Animesh810/Potentiostat/README.md

# Potentiostat
Potentiostat with an accuracy of 1mA over -0.7V to 0.7V.

The device is used to perform cyclic voltamettry. 
For more details read the report included.

Originally tested in Arduino Mega and Arduino Nano.
But can be used on any Arduino.
