Animesh810/Potentiostat/pics of report/R = 1Kohm (1).png

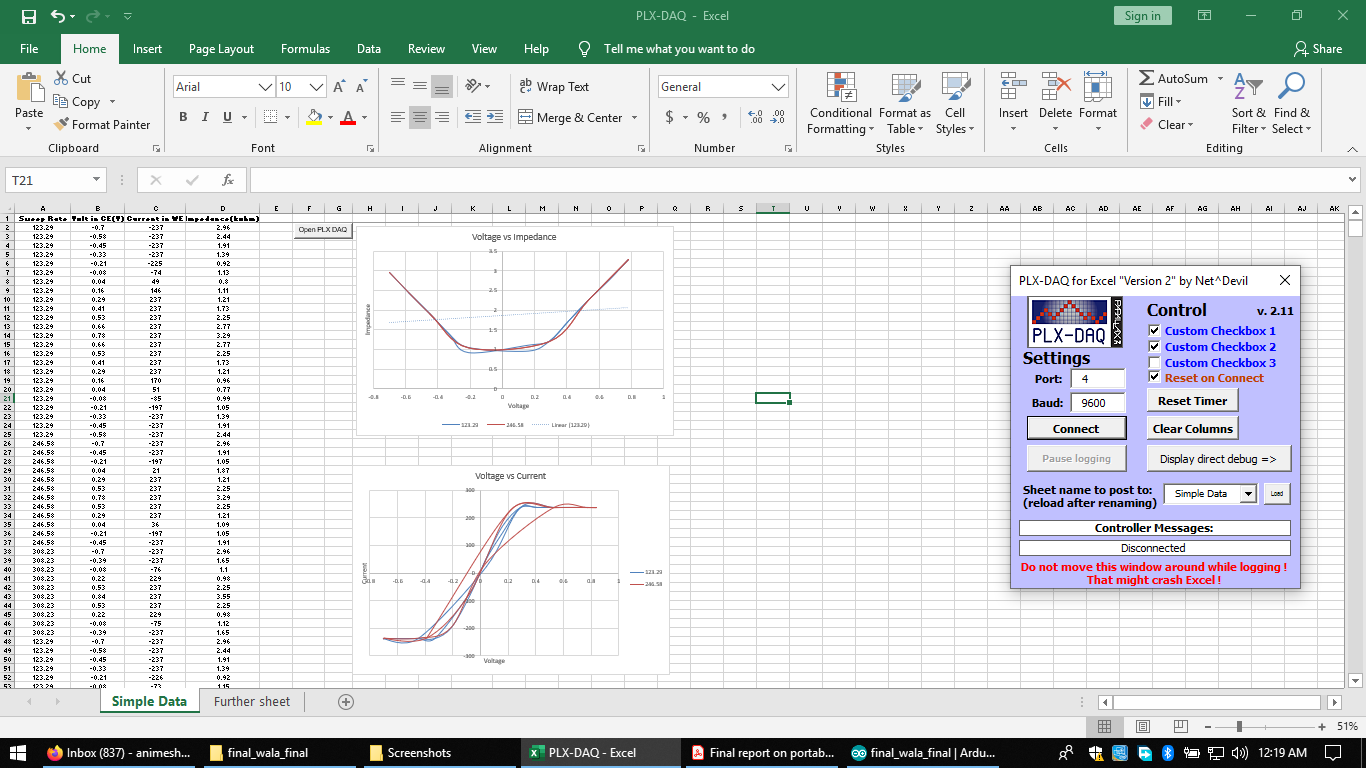
pics of report/R = 1Kohm (1).png
