Animesh810/Potentiostat/pics of report/R = 1Kohm (2).png

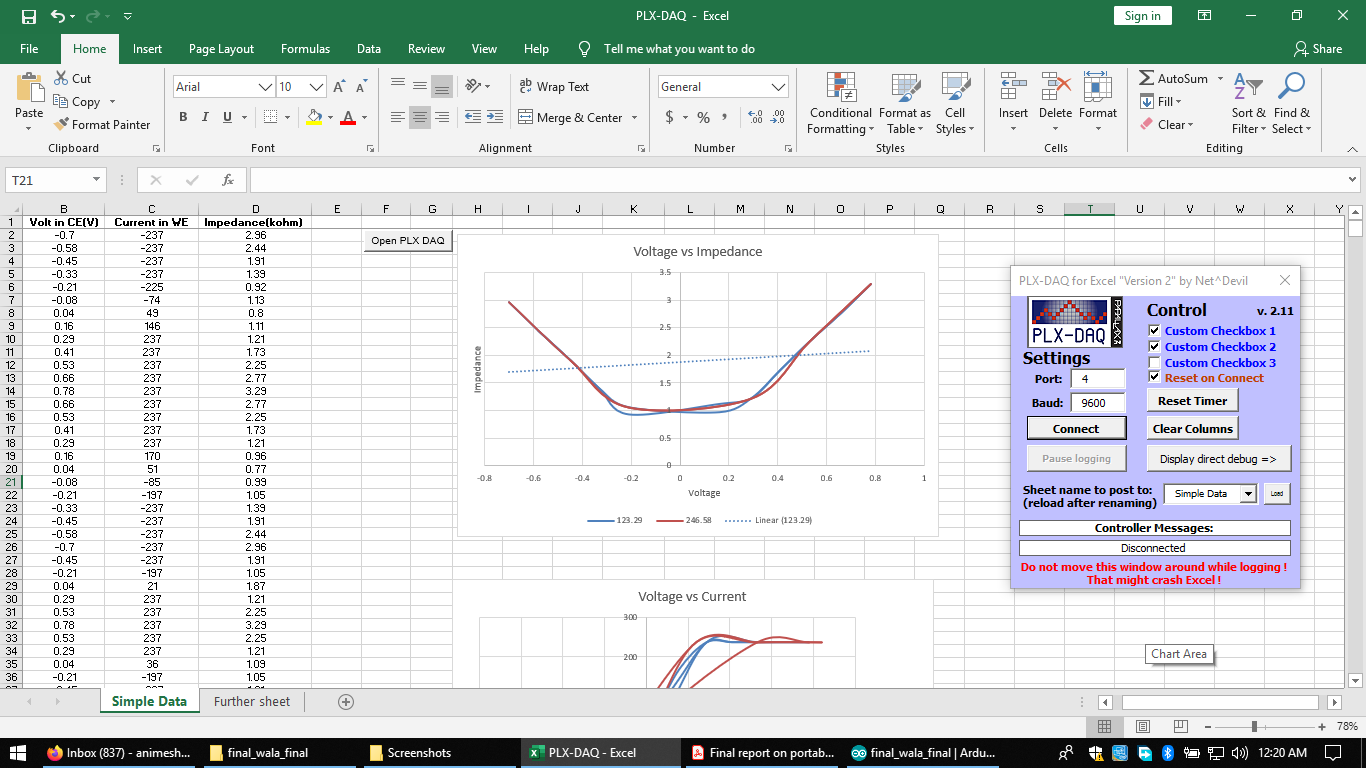
pics of report/R = 1Kohm (2).png
