Animesh810/Potentiostat/pics of report/R = 1Kohm (3).png

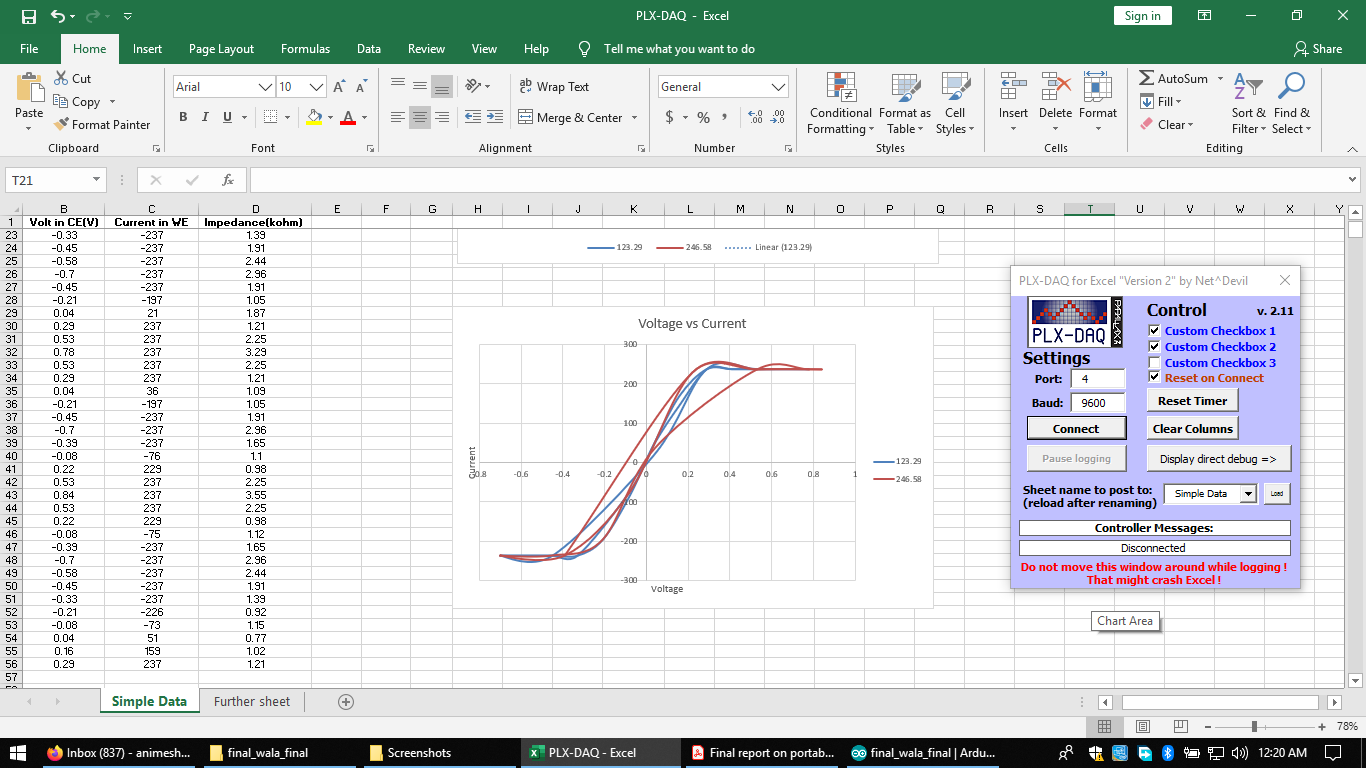
pics of report/R = 1Kohm (3).png
