Animesh810/Potentiostat/pics of report/R = 2Kohm (1).png

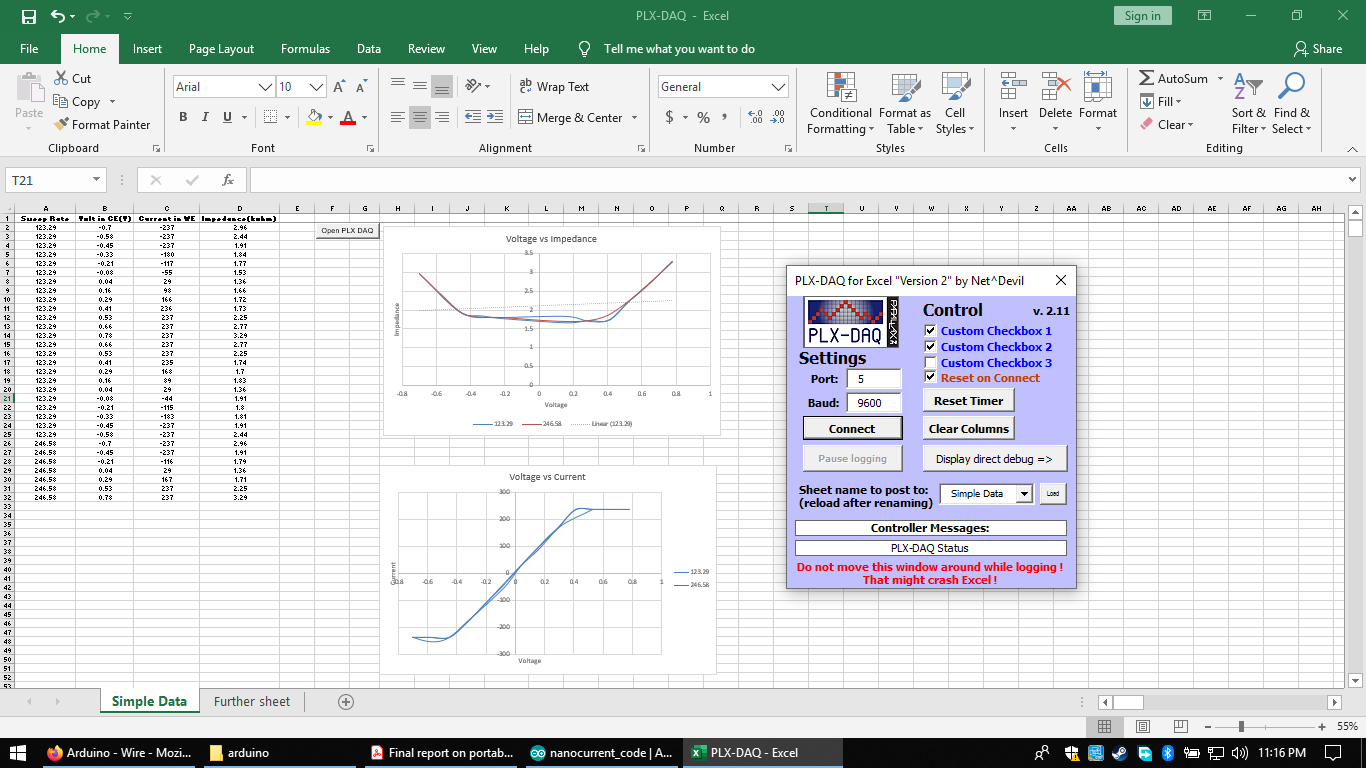
pics of report/R = 2Kohm (1).png
