Animesh810/Potentiostat/pics of report/R = 2Kohm (2).png

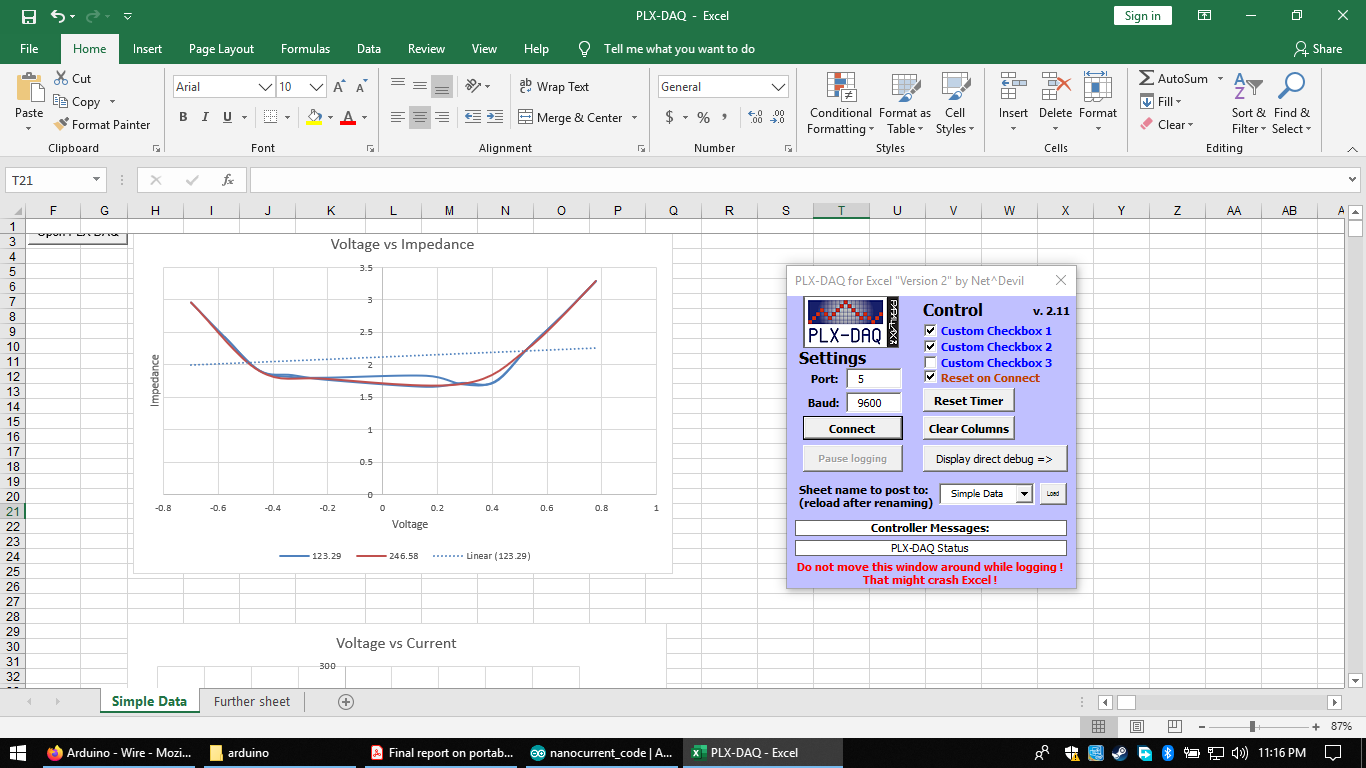
pics of report/R = 2Kohm (2).png
