Animesh810/Potentiostat/pics of report/R = 2Kohm (3).png

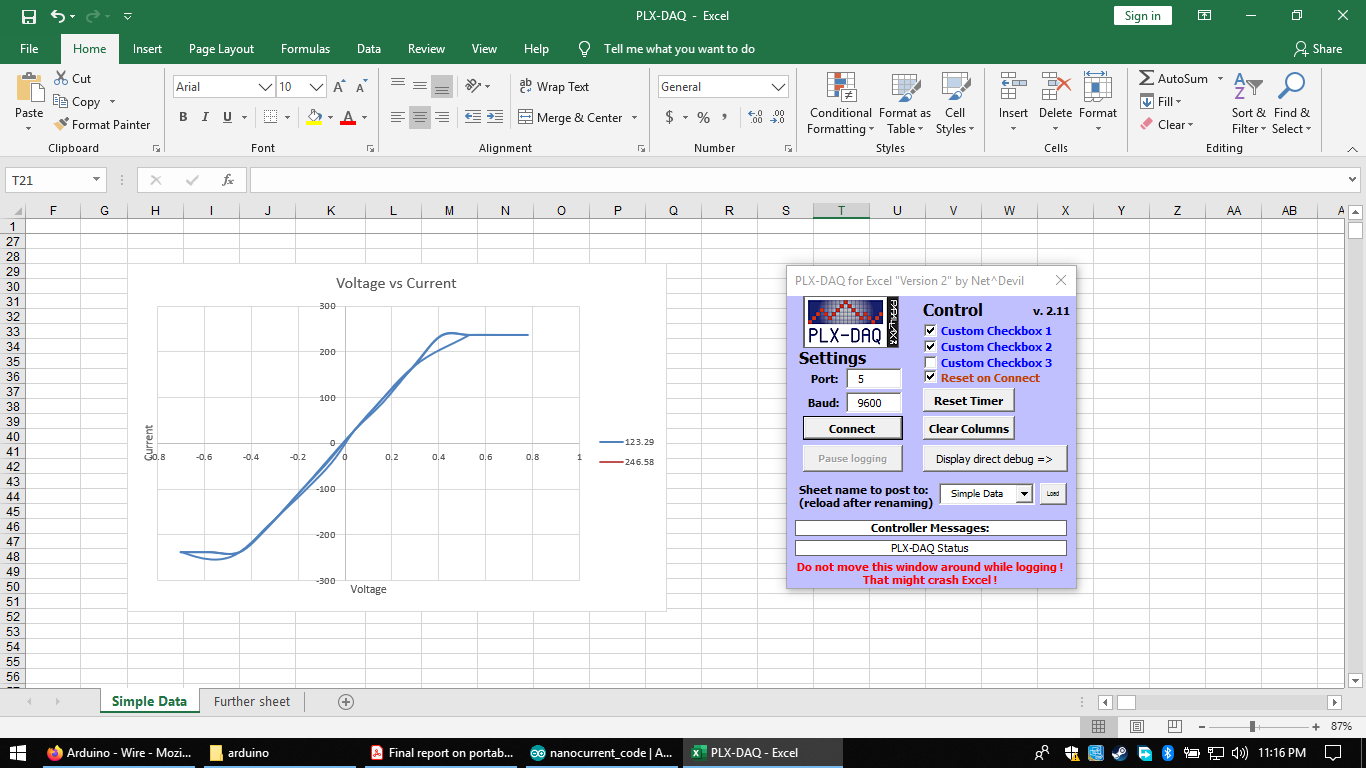
pics of report/R = 2Kohm (3).png
