Animesh810/Potentiostat/pics of report/R = 10Kohm (1).png

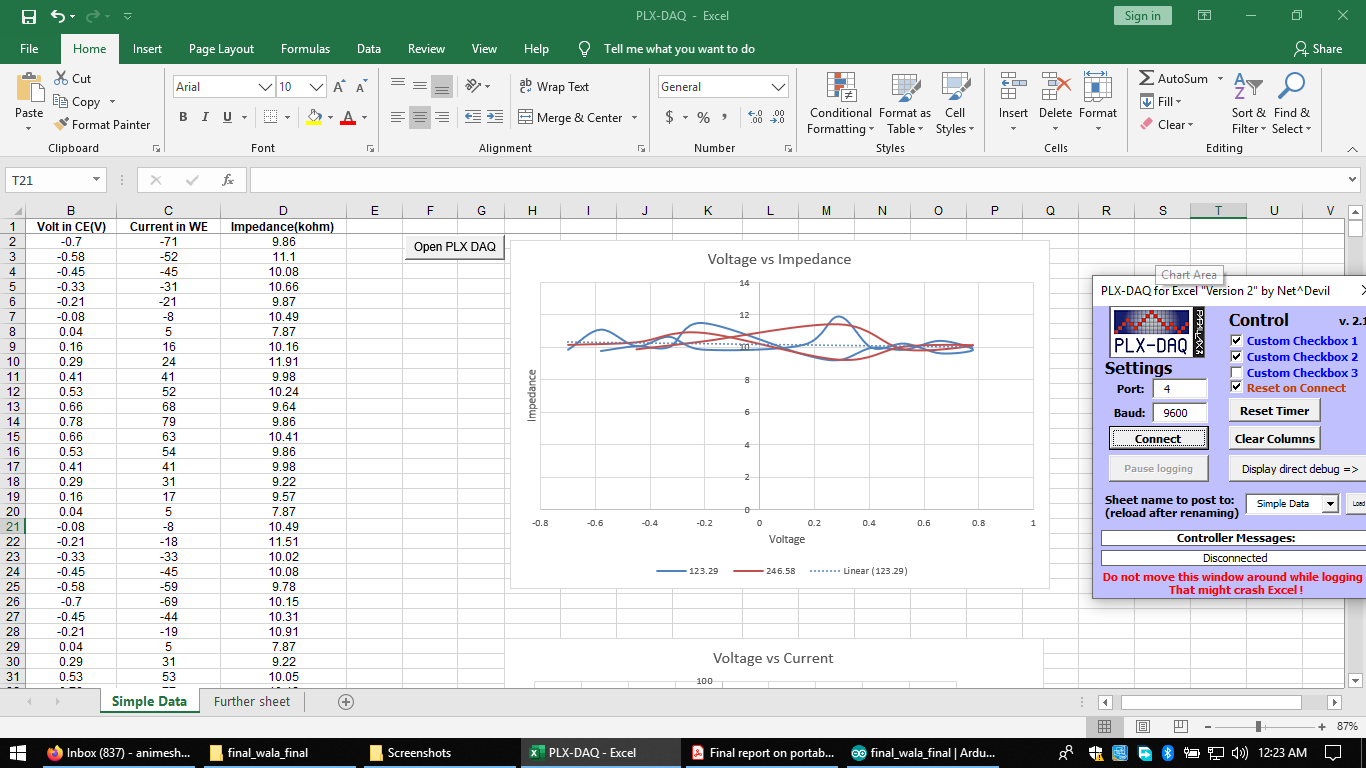
pics of report/R = 10Kohm (1).png
