Animesh810/Potentiostat/pics of report/R = 10Kohm (2).png

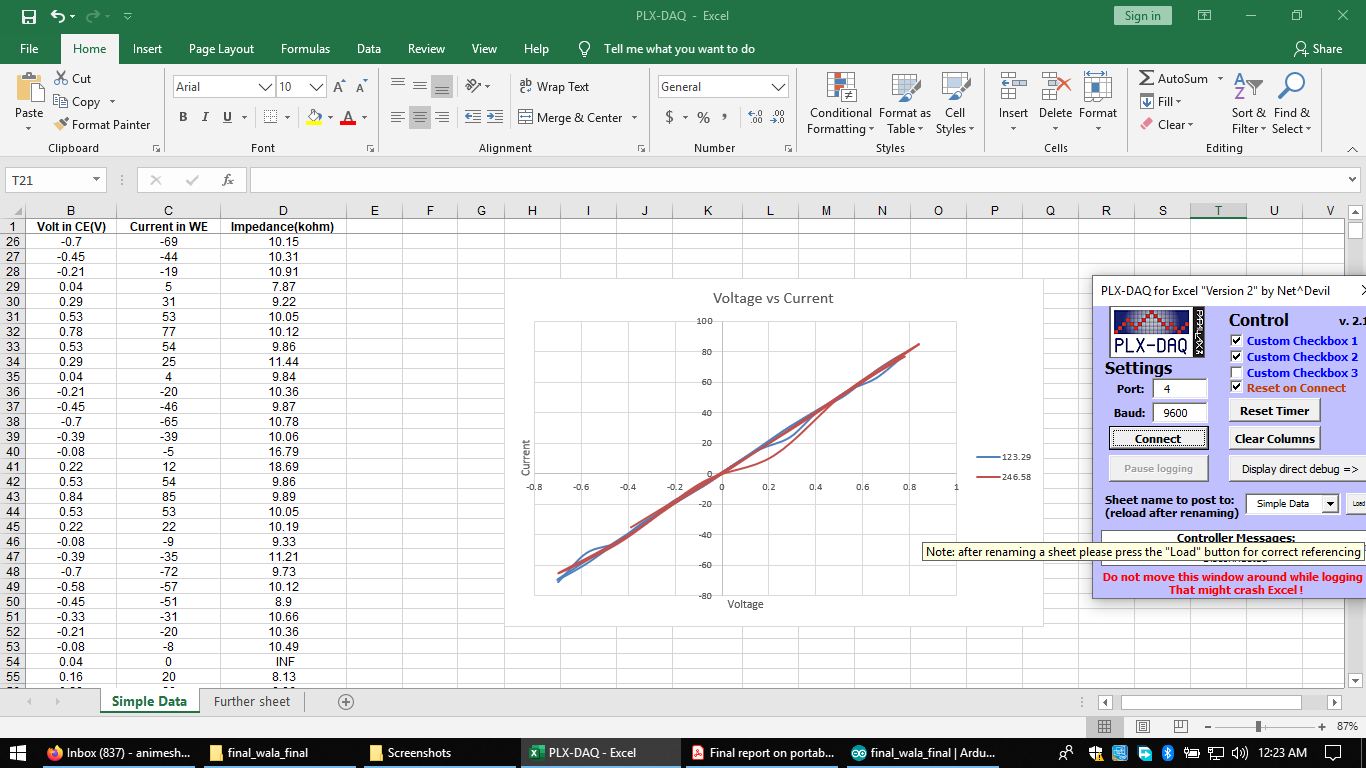
pics of report/R = 10Kohm (2).png
