Animesh810/Potentiostat/pics of report/R = 10Kohm (3).png

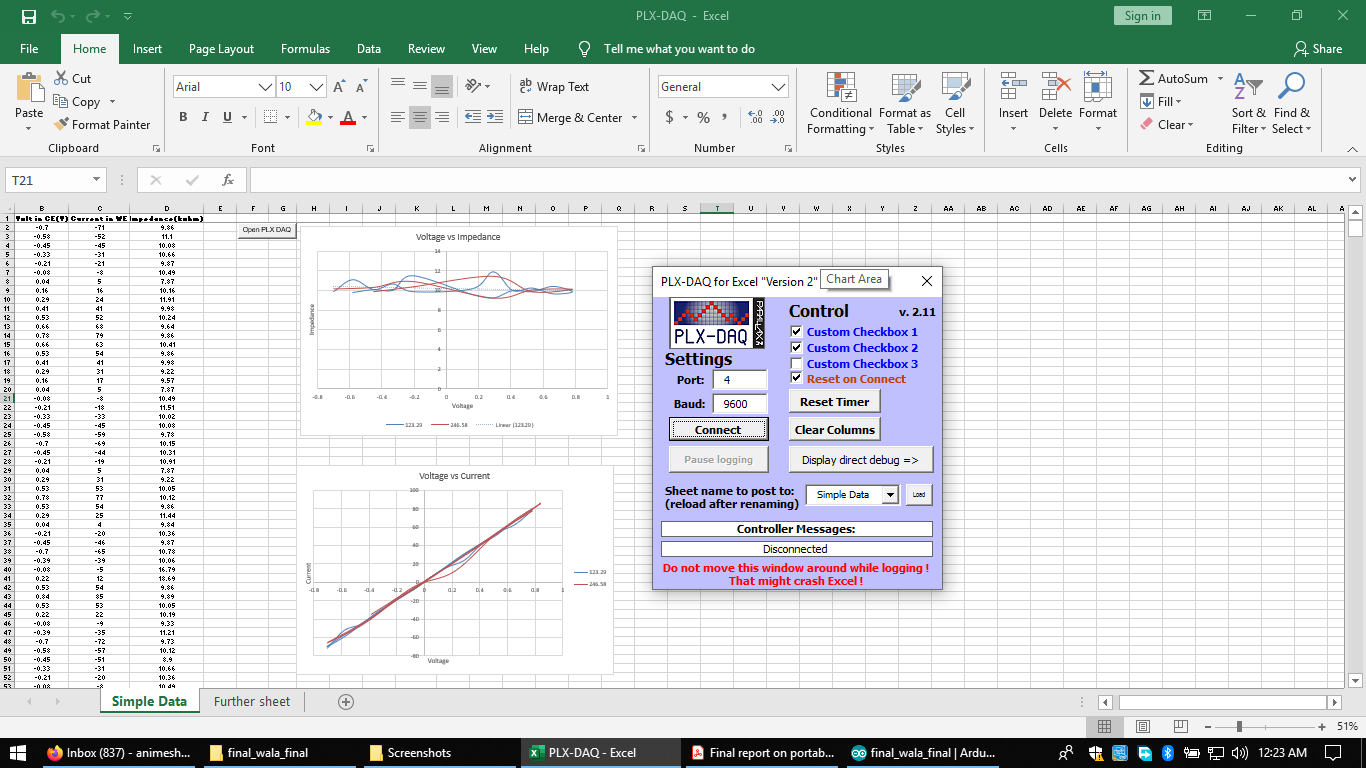
pics of report/R = 10Kohm (3).png
